youssefvdel/Solar-Tracker-Embedded/Photos/WhatsApp Image 2026-04-30 at 9.24.32 AM (1).jpeg

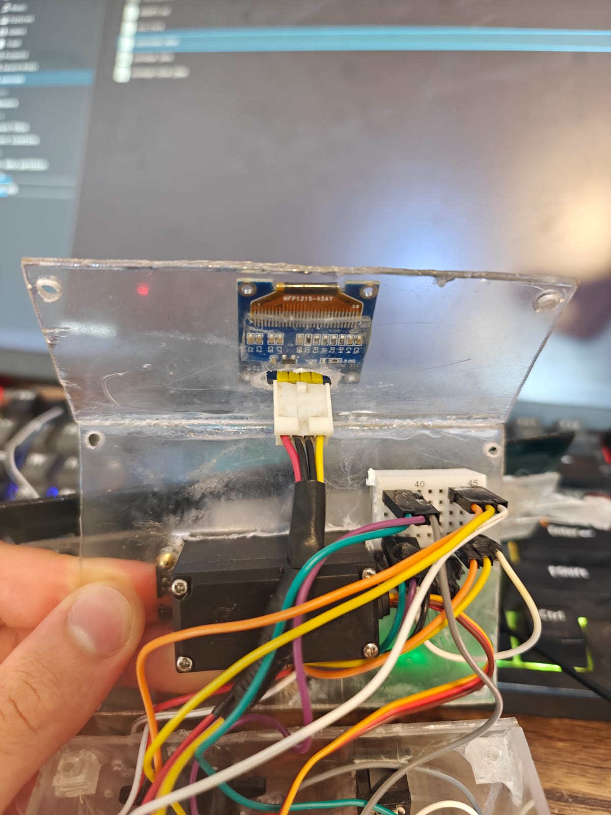
Photos/WhatsApp Image 2026-04-30 at 9.24.32 AM (1).jpeg
