youssefvdel/Solar-Tracker-Embedded/Photos/WhatsApp Unknown 2026-04-30 at 8.14.58 PM/WhatsApp Image 2026-04-16 at 5.55.32 PM.jpeg

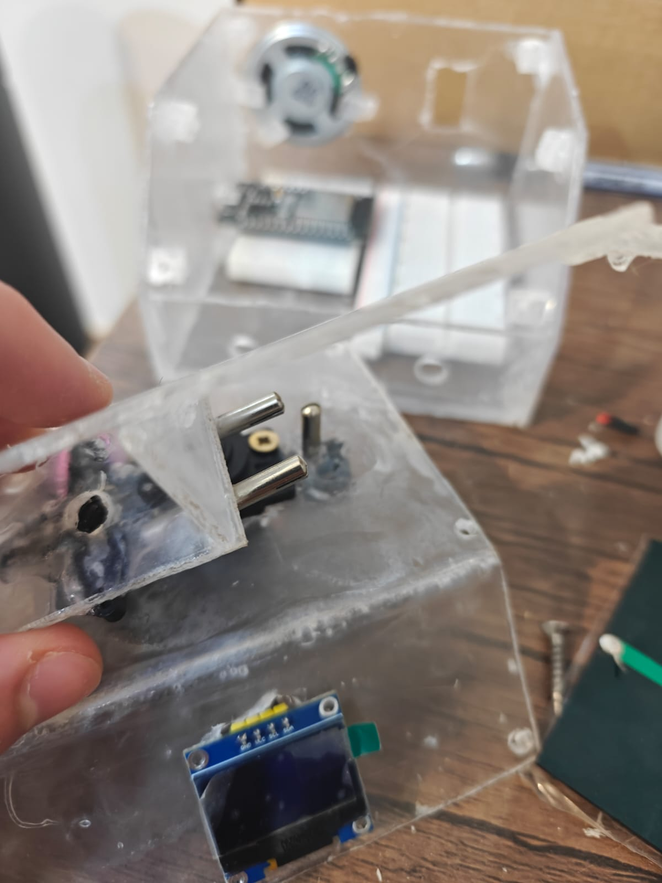
Photos/WhatsApp Unknown 2026-04-30 at 8.14.58 PM/WhatsApp Image 2026-04-16 at 5.55.32 PM.jpeg
