youssefvdel/Solar-Tracker-Embedded/image gen/ChatGPT Image Apr 30, 2026, 08_55_58 PM.png

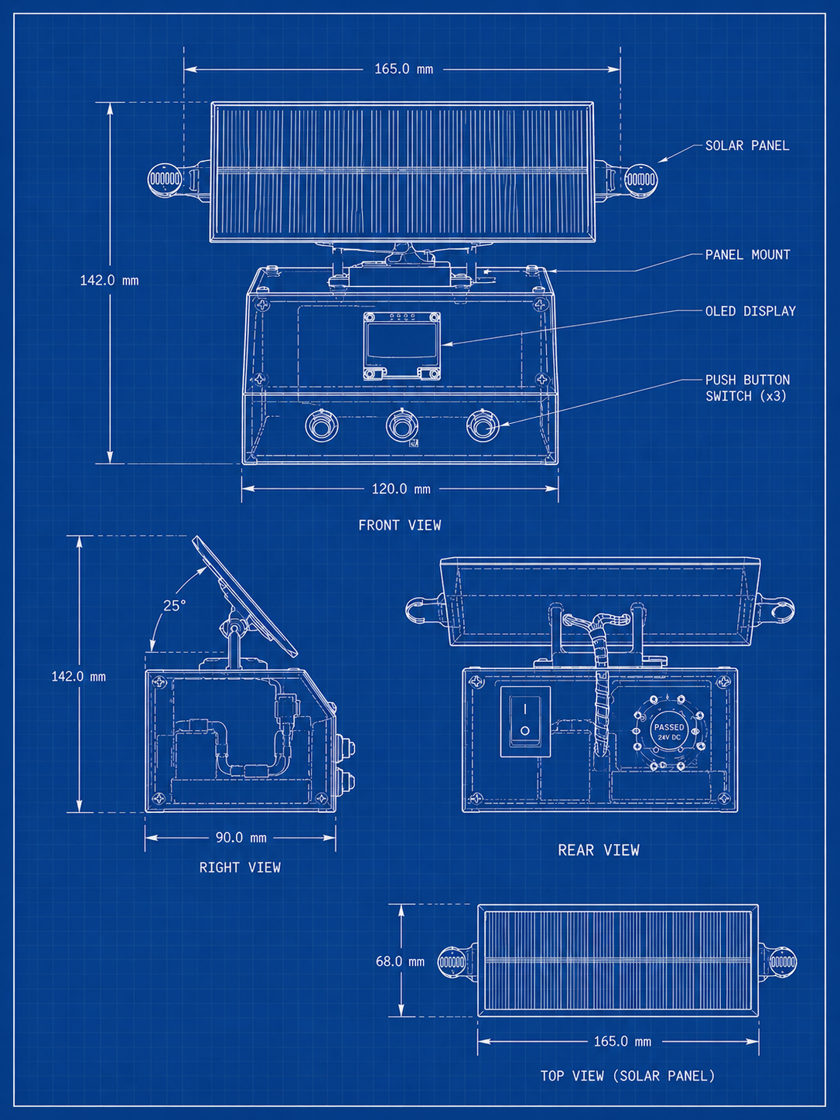
image gen/ChatGPT Image Apr 30, 2026, 08_55_58 PM.png
