youssefvdel/Solar-Tracker-Embedded/image gen/solar-tracker-blueprint-v2.png

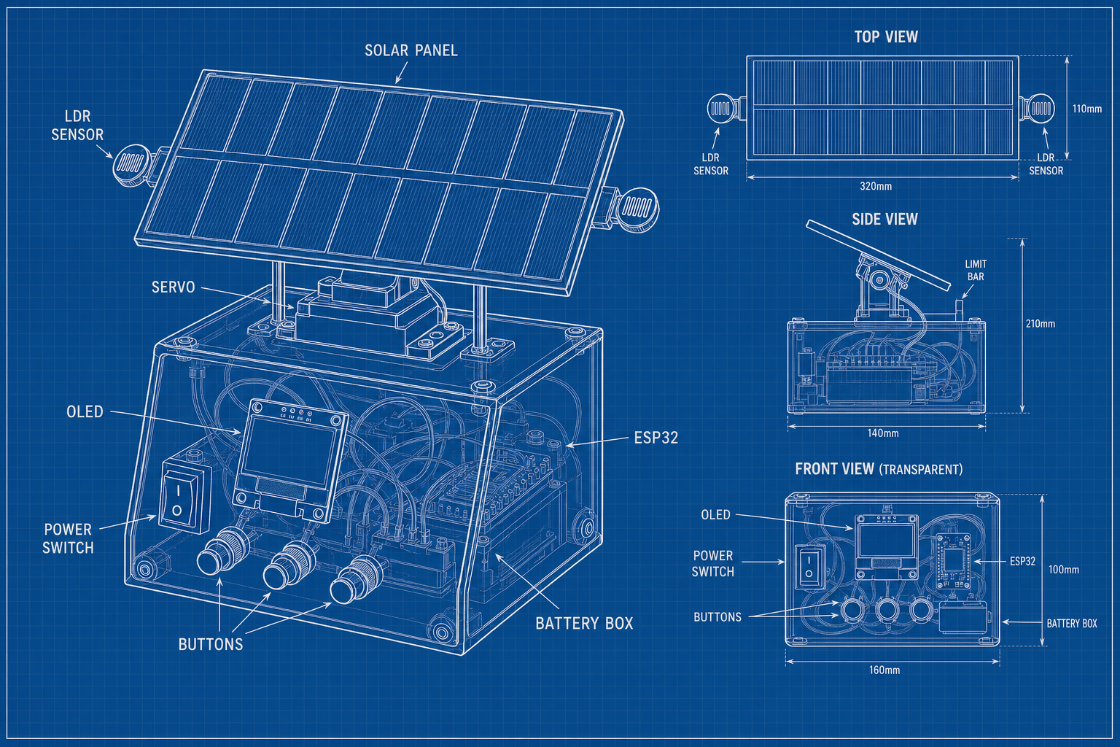
image gen/solar-tracker-blueprint-v2.png
