youssefvdel/Solar-Tracker-Embedded/image gen/solar-tracker-blueprint.png

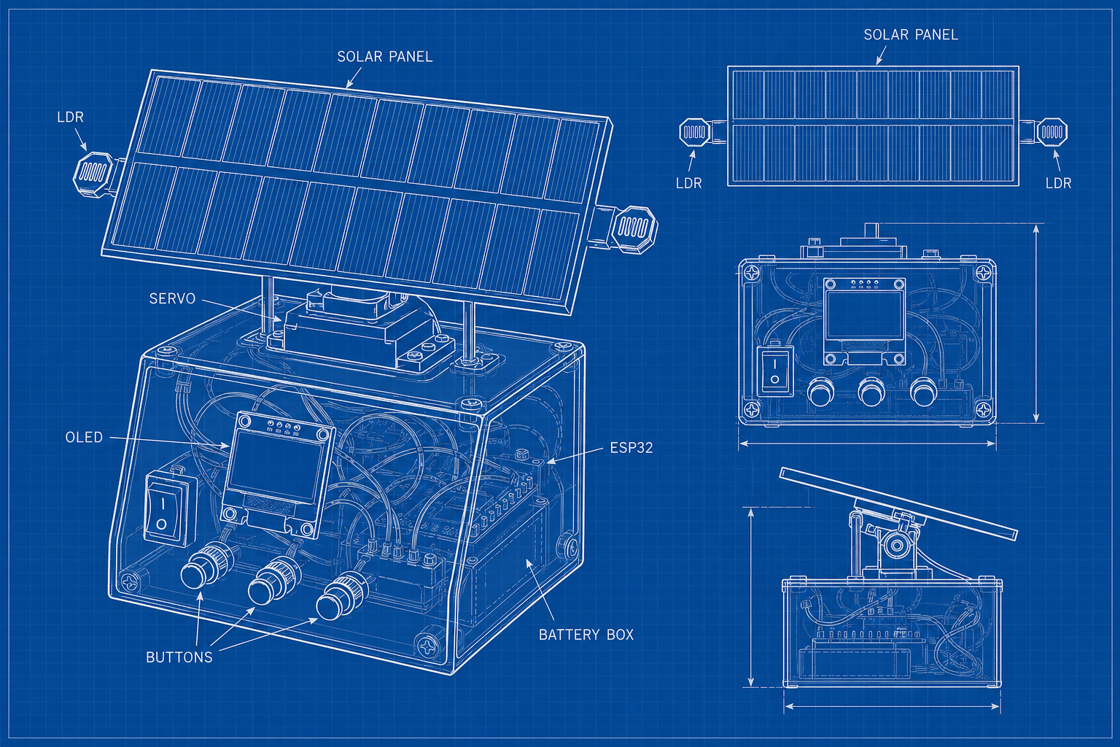
image gen/solar-tracker-blueprint.png
