youssefvdel/Solar-Tracker-Embedded/Photos/IMG20260430201646.jpg

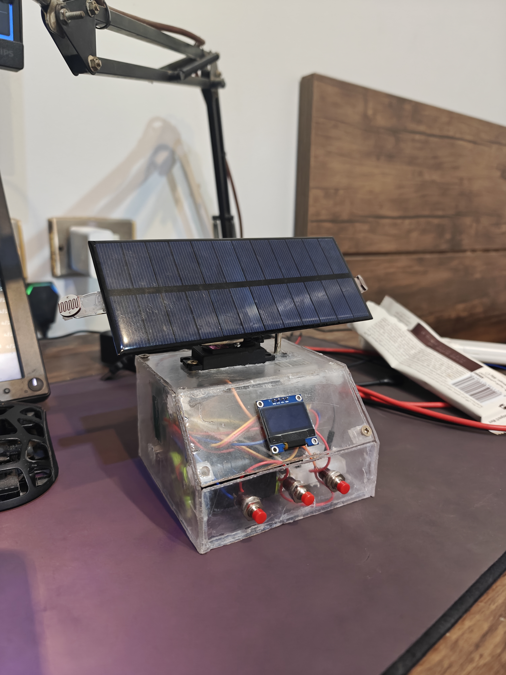
Photos/IMG20260430201646.jpg
