youssefvdel/Solar-Tracker-Embedded/Photos/IMG20260430201651.jpg

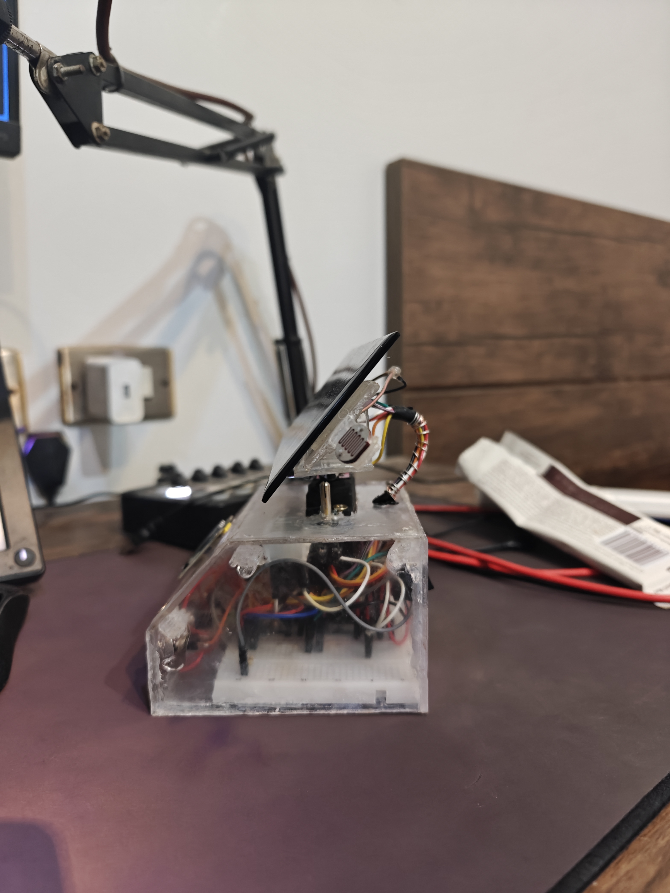
Photos/IMG20260430201651.jpg
