youssefvdel/Solar-Tracker-Embedded/Photos/IMG20260430201701.jpg

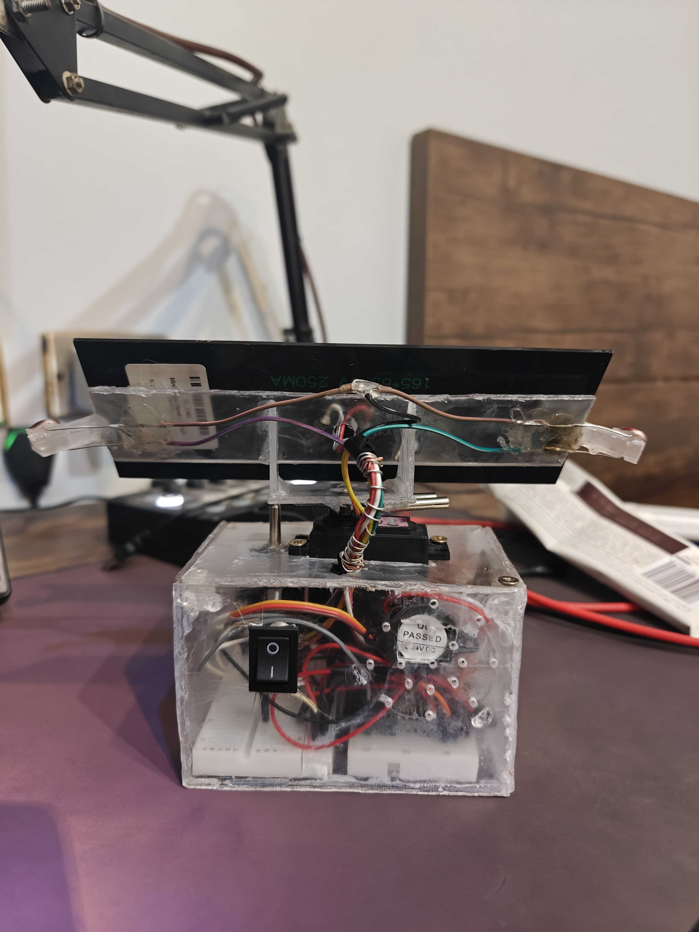
Photos/IMG20260430201701.jpg
