youssefvdel/Solar-Tracker-Embedded/Photos/IMG20260430201709.jpg

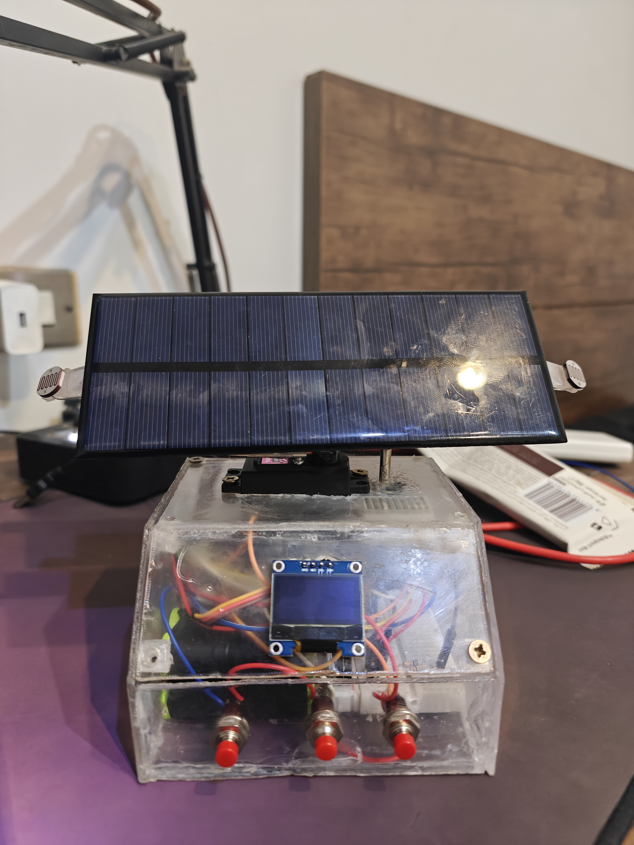
Photos/IMG20260430201709.jpg
