youssefvdel/Solar-Tracker-Embedded/Photos/WhatsApp Image 2026-04-30 at 9.20.50 AM.jpeg

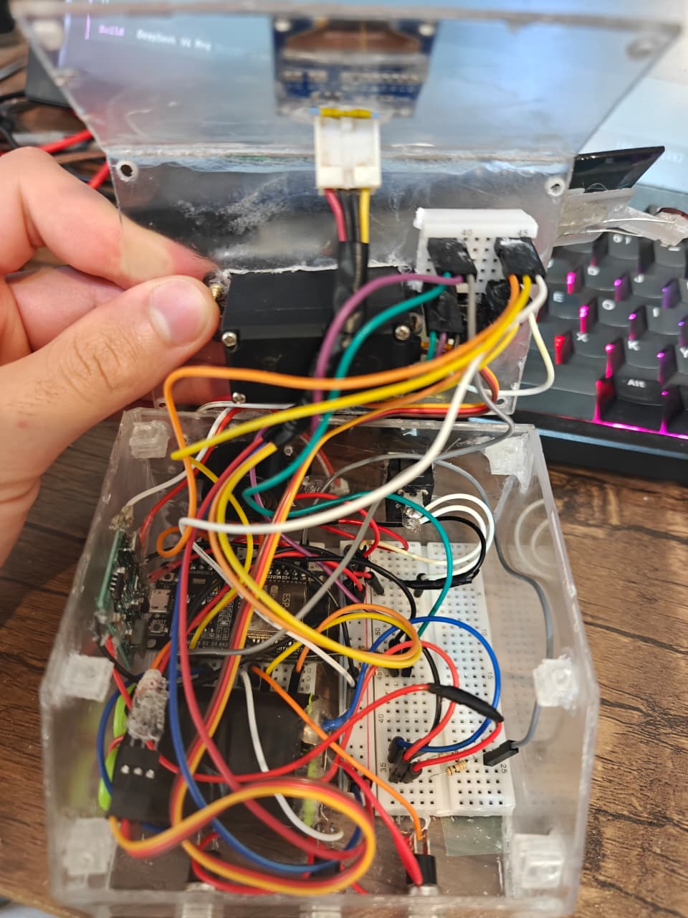
Photos/WhatsApp Image 2026-04-30 at 9.20.50 AM.jpeg
