youssefvdel/Solar-Tracker-Embedded/Photos/WhatsApp Unknown 2026-04-30 at 8.14.58 PM/WhatsApp Image 2026-04-14 at 8.21.13 PM.jpeg

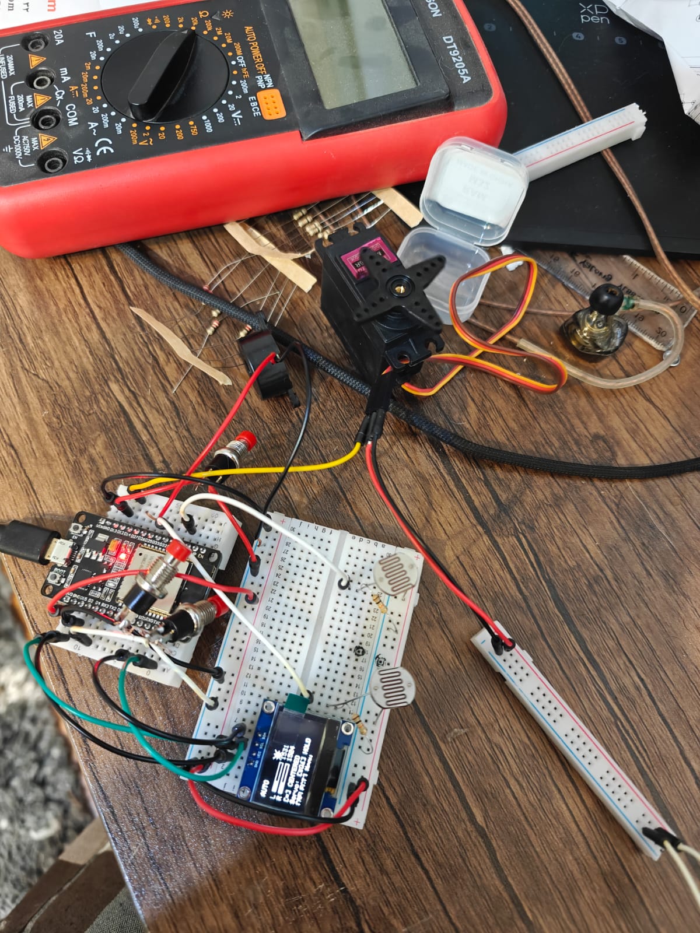
Photos/WhatsApp Unknown 2026-04-30 at 8.14.58 PM/WhatsApp Image 2026-04-14 at 8.21.13 PM.jpeg
