youssefvdel/Solar-Tracker-Embedded/Photos/WhatsApp Unknown 2026-04-30 at 8.14.58 PM/WhatsApp Image 2026-04-15 at 5.34.37 PM (1).jpeg

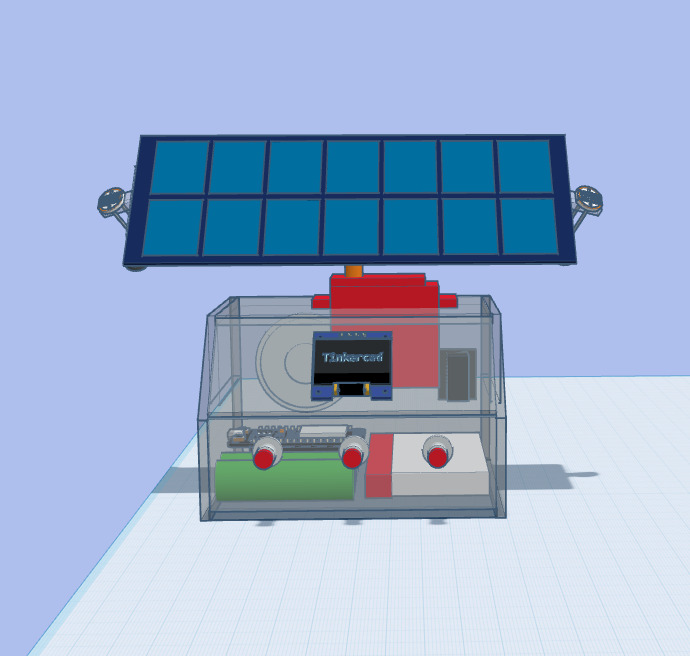
Photos/WhatsApp Unknown 2026-04-30 at 8.14.58 PM/WhatsApp Image 2026-04-15 at 5.34.37 PM (1).jpeg
