youssefvdel/Solar-Tracker-Embedded/screenshot/Embedded System2.jpg

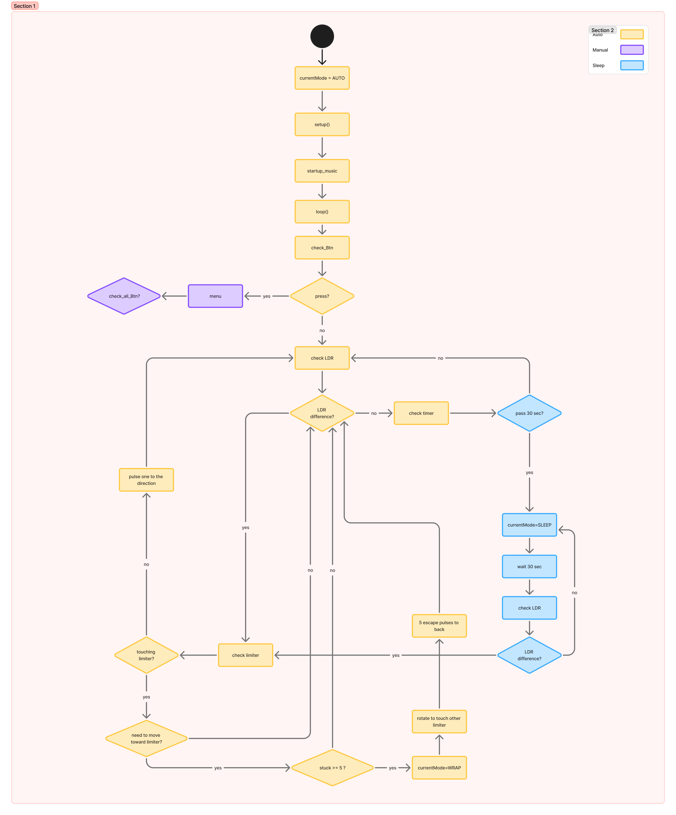
screenshot/Embedded System2.jpg
