youssefvdel/Solar-Tracker-Embedded/screenshot/Embedded System3.jpg

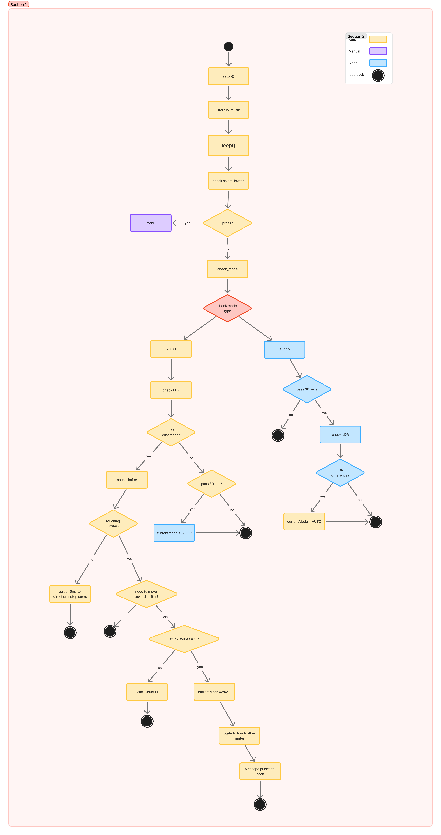
screenshot/Embedded System3.jpg
