youssefvdel/Solar-Tracker-Embedded/screenshot/Embedded System4.jpg

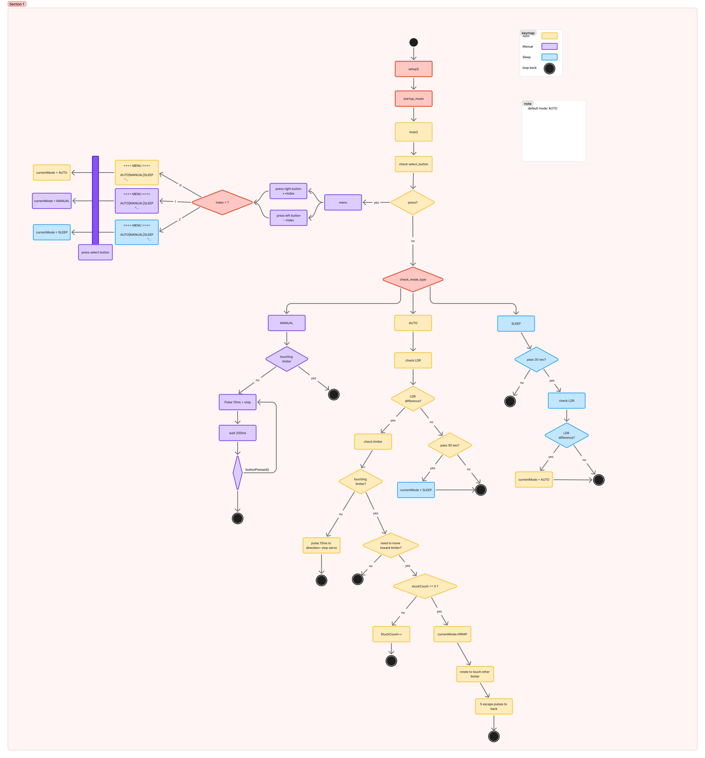
screenshot/Embedded System4.jpg
