youssefvdel/Solar-Tracker-Embedded/screenshot/Embedded System5.jpg

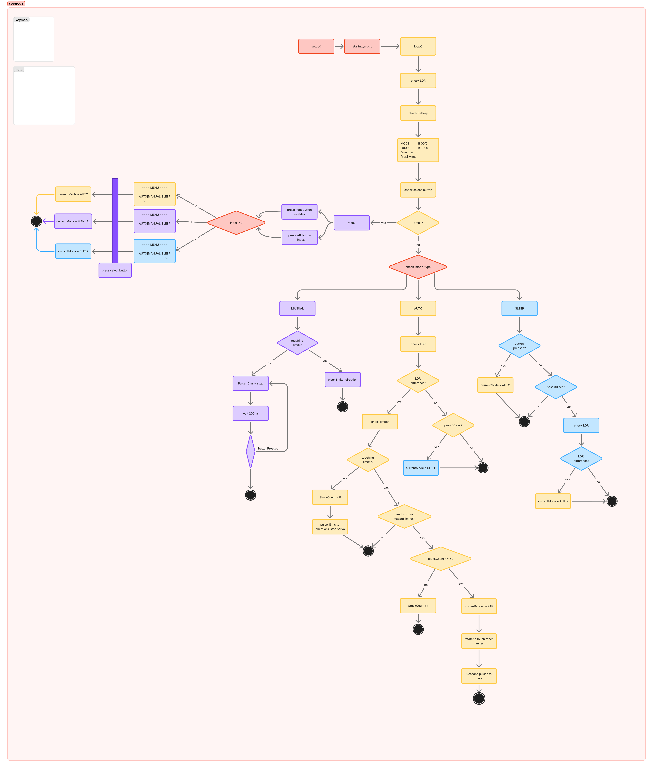
screenshot/Embedded System5.jpg
