youssefvdel/Solar-Tracker-Embedded/screenshot/Embedded System.jpg

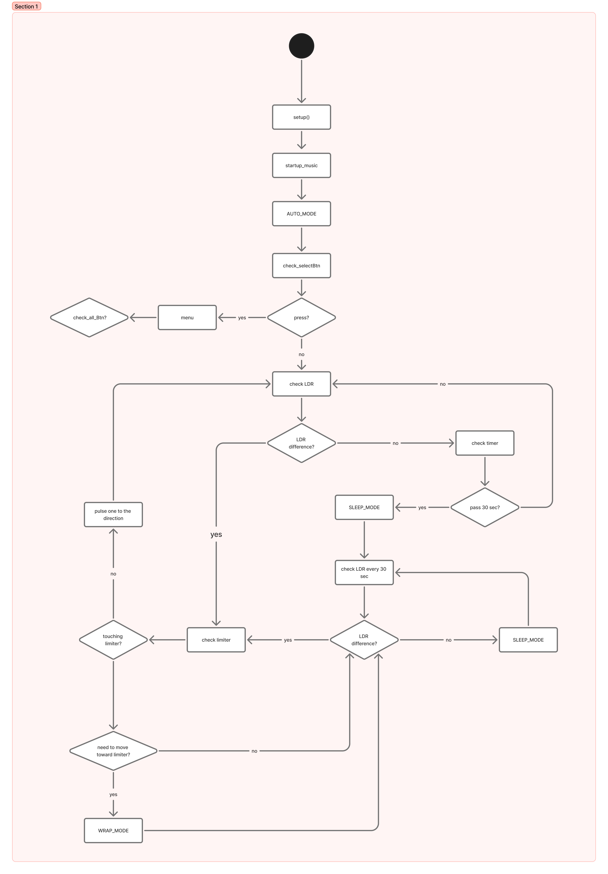
screenshot/Embedded System.jpg
