youssefvdel/Solar-Tracker-Embedded/screenshot/ss1.jpg

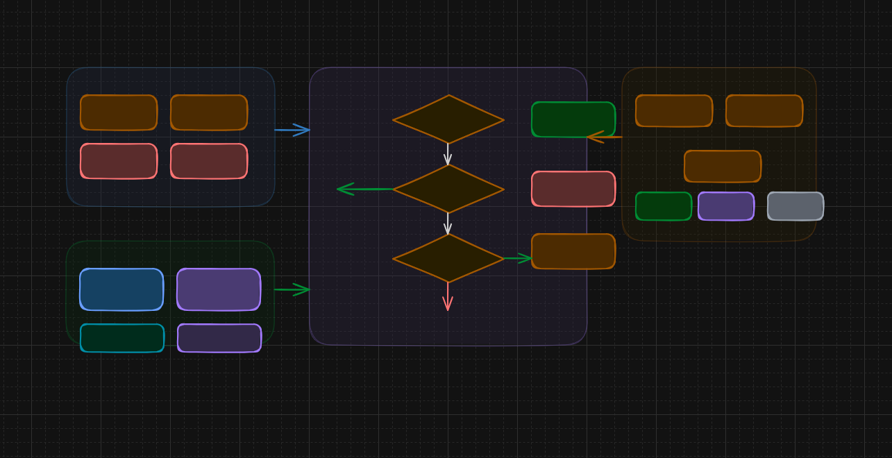
screenshot/ss1.jpg
