youssefvdel/Solar-Tracker-Embedded/(commit log)

2026-04-14 initial commit: ESP32 sun tracker with animated OLED UI, 3-button menu, deep sleep, rhythmic buzzer feedback
2026-04-14 clean docs: remove emojis, update to current state, fix outdated references
2026-04-14 fix: add SERVO_TRIM, improve noise filtering, add common ground note
    [Solar-Tracker-Embedded.ino]
2026-04-15 debug: add action printout to serial, increase servo speed for testing
2026-04-15 add LDR_OFFSET to balance sensor manufacturing differences
2026-04-15 update servo challenge: added disassembly and hardware inspection details
2026-04-15 fix pulse-based tracking: move briefly then stop, reset LDR_OFFSET to 0, remove duplicate code
    [Solar-Tracker-Embedded.ino]
2026-04-15 servo tracking calibrated: CW and CCW move equal distance, 135 degree range (sufficient for 9hr sun tracking)
2026-04-15 add hardware limit switches on GPIO 18/19, auto-reset angle on hit
    [Solar-Tracker-Embedded.ino]
2026-04-15 remove software angle tracking, rely on hardware limit switches only, simplify tracking logic
2026-04-15 stable limit switch release: instant override at top of loop, minor overshoot acceptable
    [Solar-Tracker-Embedded.ino]
2026-04-20 Refactor Solar Tracker firmware and add .theia config
    Major refactor of Solar-Tracker-Embedded.ino: reorganized configuration into clearly named sections, replaced many legacy globals with typed constants/structs/enums, and modularized functionality (sensors, tracking, buttons, display, buzzer, sleep). Renamed objects (display→oled, sunServo→trackerServo), simplified LDR sampling/averaging, consolidated battery handling, changed servo/timing/pulse logic and hysteresis handling, and introduced a simple menu system with actions (Auto/Manual/Sleep) and tone patterns. Boot animation removed and idle deep-sleep is commented for testing. Also adds a minimal .theia/launch.json file for editor l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
    [Solar-Tracker-Embedded.ino]
2026-04-23 feat: 360° wrap mode, pulsed manual control, 30s idle sleep
    Major changes:
    - Add 360° wrap mode with copper limit switches
    - Detects when stuck at limit (LDR wants same direction for 5 cycles)
    - Wraps full-speed to opposite limit, then 3 escape pulses
    - Slower wrap speed (45/135) to avoid pushing through copper bar
    - Manual mode now uses pulses while holding button (same rhythm as auto)
    - Add 30-second idle sleep: sleeps if no servo movement for 30s
    - Wakes every 30s to check, pulses if needed, sleeps again if centered
    - Fix limit switch direction mapping (swapped pins 13/15)
    - Non-blocking servo pulses (no delay() in tracking loop)
    - Debounced limit switches (3 consecutive LOW rea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
    [Solar-Tracker-Embedded.ino]
2026-04-29 refactor(Solar-Tracker-Embedded): optimize code and improve battery handling
    - Replace const with static constexpr for compile-time optimization
    - Remove unused VSCode and Theia configuration files
    - Simplify readSensors() function by removing smoothing buffer
    - Implement voltageToPercent() lookup table for battery percentage calculation
    - Extend eclipse escape steps from 3 to 5
    - Remove auto sleep mode to prevent resets and timing issues
    - Improve battery voltage and percentage logging
    [Solar-Tracker-Embedded.ino]
2026-04-30 fix: remove unnecessary whitespace
    - Deleted empty lines at the beginning and end of the code snippet
    - This change helps to maintain clean and concise code structure
    [Solar-Tracker-Embedded.ino]
2026-04-30 chore: adjust battery voltage and divider settings
    - Update BATT_DIVIDER from 2.0f to 2.30f for more accurate voltage reading
    - Adjust BATT_V_MAX from 4.2f to 4.1f to reflect the actual battery voltage
    - These changes improve the accuracy of battery level monitoring
    Refines battery voltage calibration for accuracy
    Updates battery voltage divider ratio and maximum voltage to improve the precision of battery level monitoring, ensuring readings better reflect actual hardware values.
2026-04-30 docs: remove mermaid diagrams and related files
    - Removed mermaid-diagrams.md file containing multiple diagrams
    - Deleted individual mermaid files (architecture.mmd, state-machine.mmd, wiring.mmd)
    - Removed workflow.svg file
    - All diagrams and visualizations have been removed from the project
